PenguinEino/opensusi-tr10-balanced-ternary-logic/layout/art/preview.png

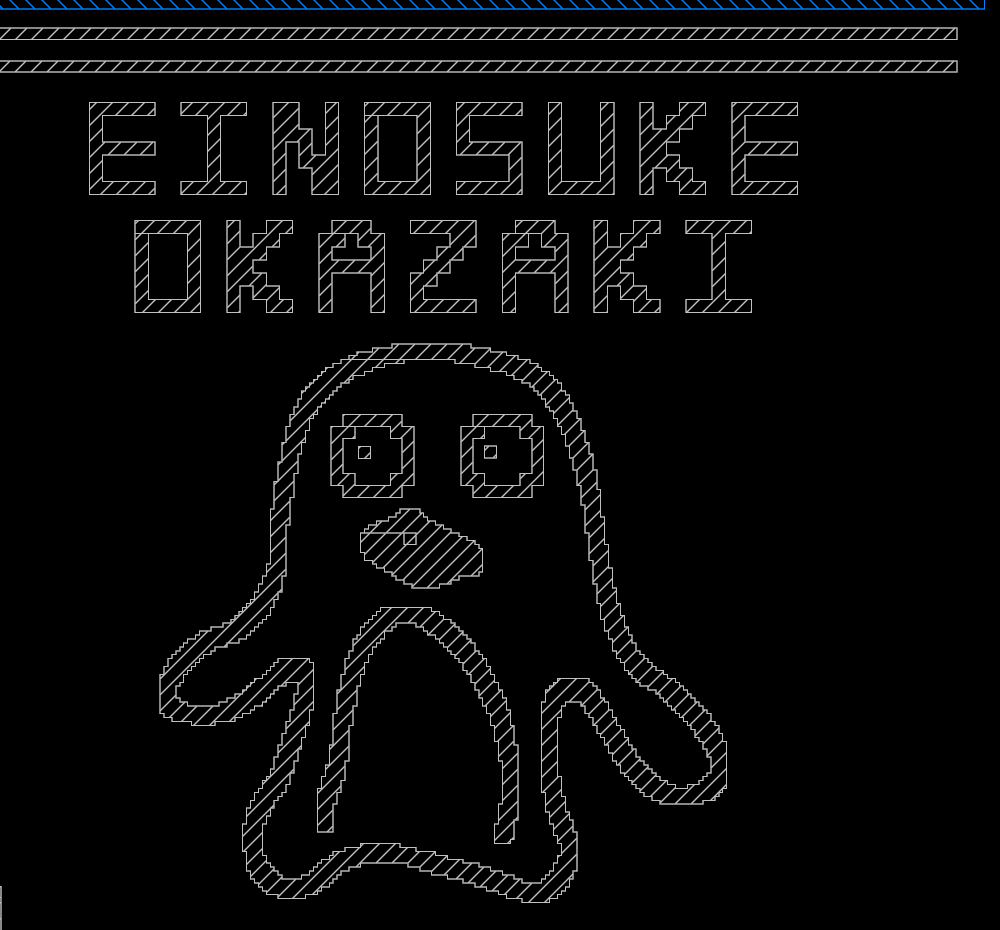
layout/art/preview.png
