PenguinEino/opensusi-tr10-balanced-ternary-logic/layout/full_adder.png

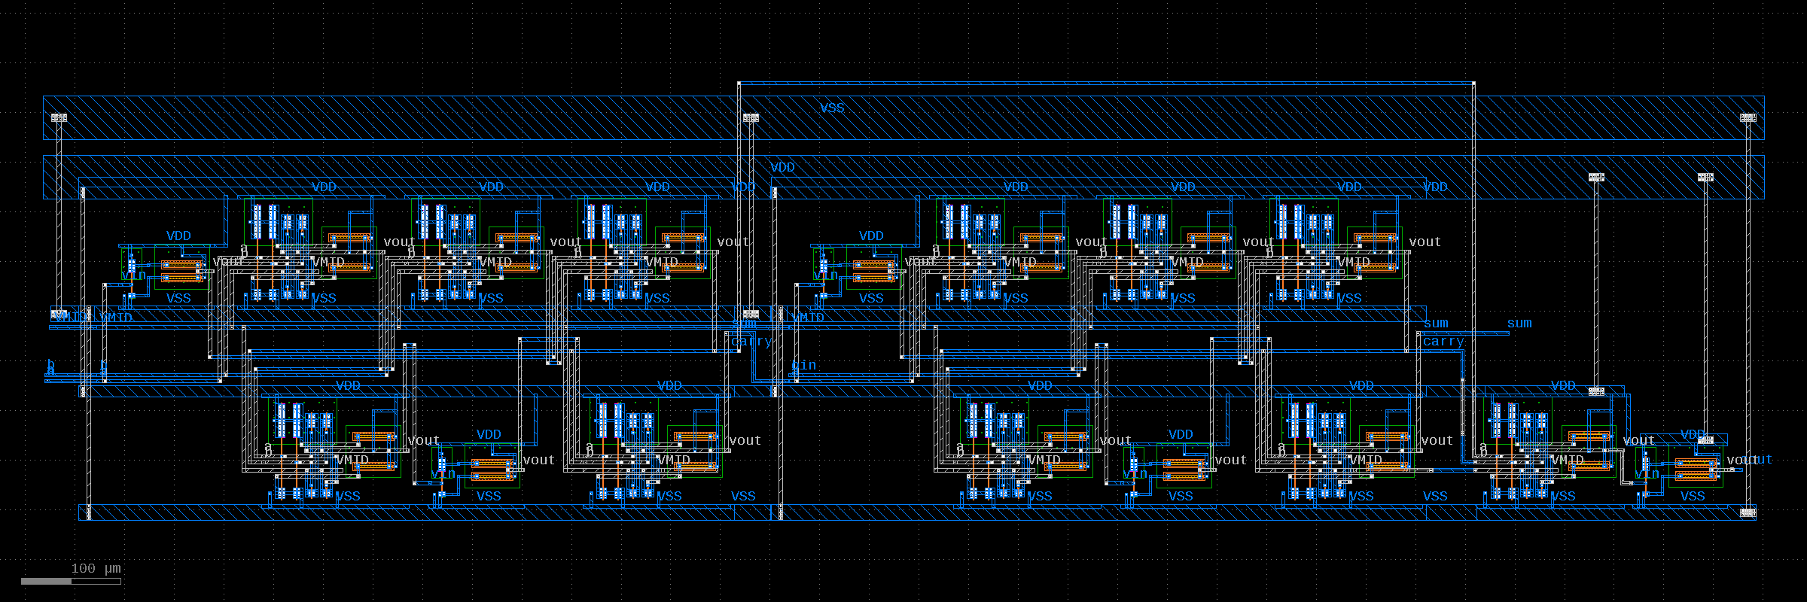
layout/full_adder.png
