PenguinEino/opensusi-tr10-balanced-ternary-logic/layout/half_adder.png

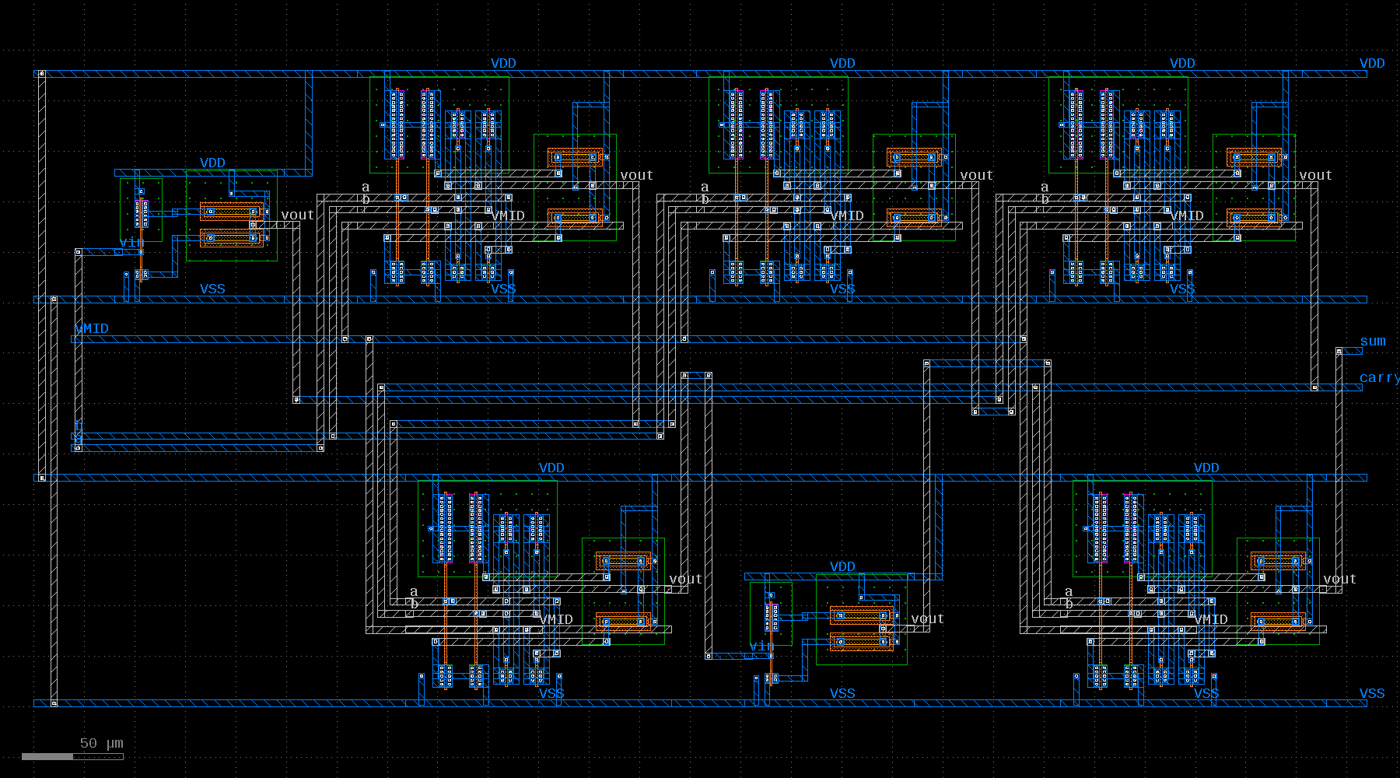
layout/half_adder.png
