PenguinEino/opensusi-tr10-balanced-ternary-logic/layout/inverter.png

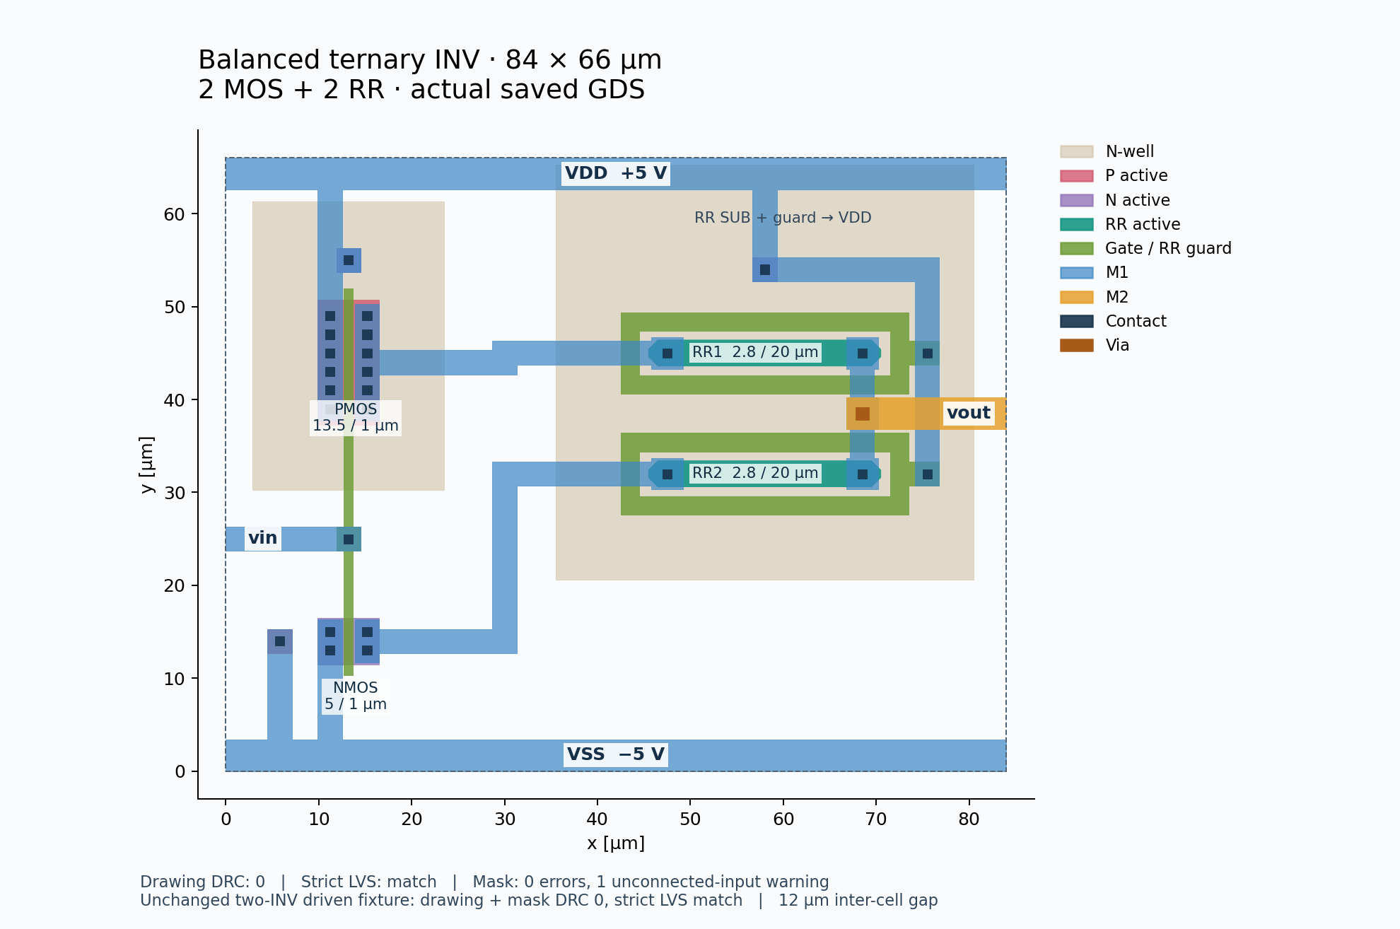
layout/inverter.png
