PenguinEino/opensusi-tr10-balanced-ternary-logic/layout/klayout/readable_terminals.png

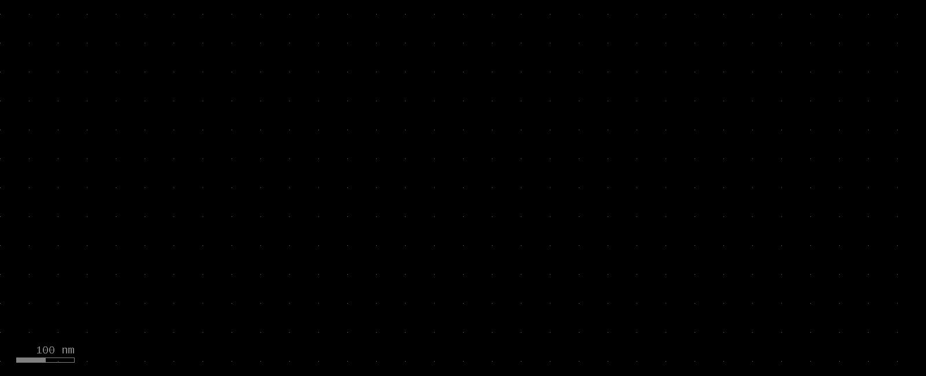
layout/klayout/readable_terminals.png
