PenguinEino/opensusi-tr10-balanced-ternary-logic/layout/mac.png

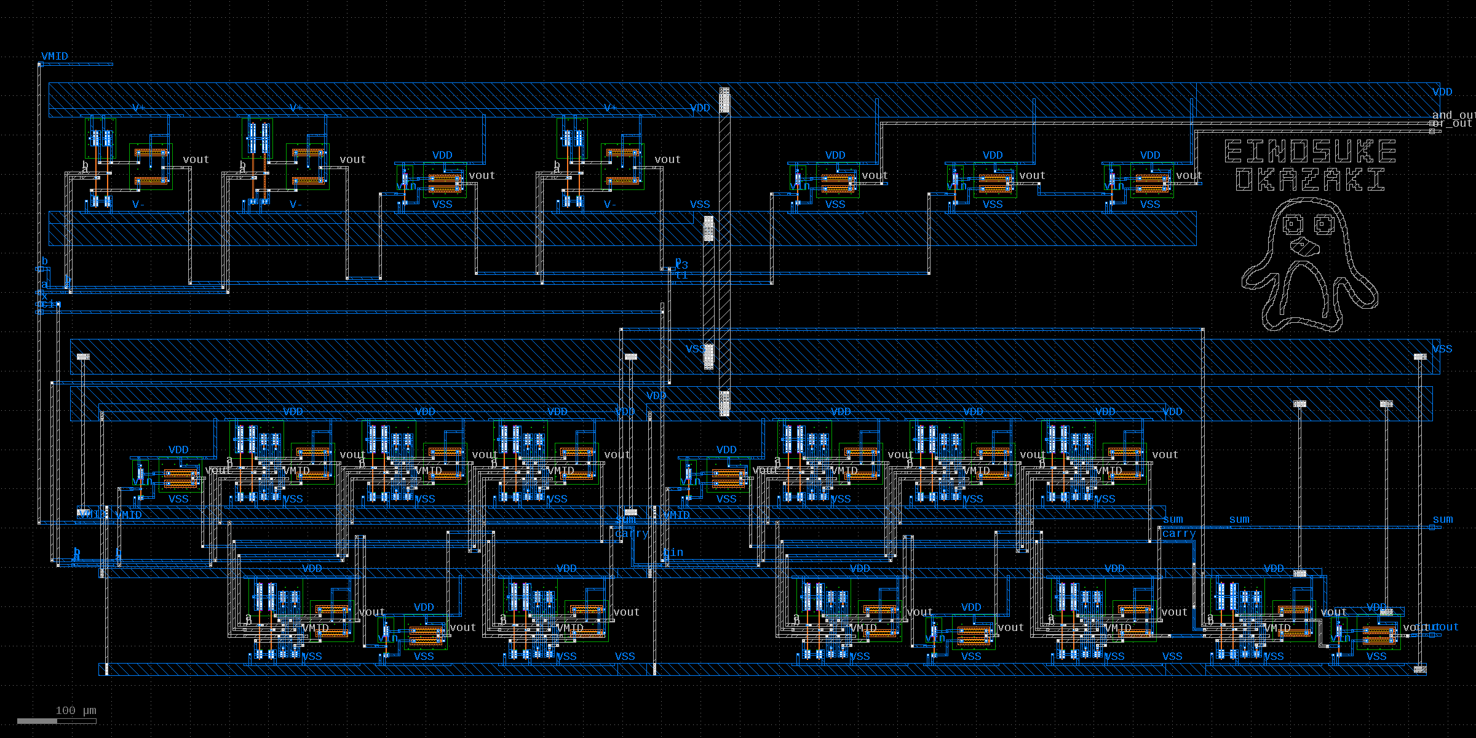
layout/mac.png
