PenguinEino/opensusi-tr10-balanced-ternary-logic/layout/mul.png

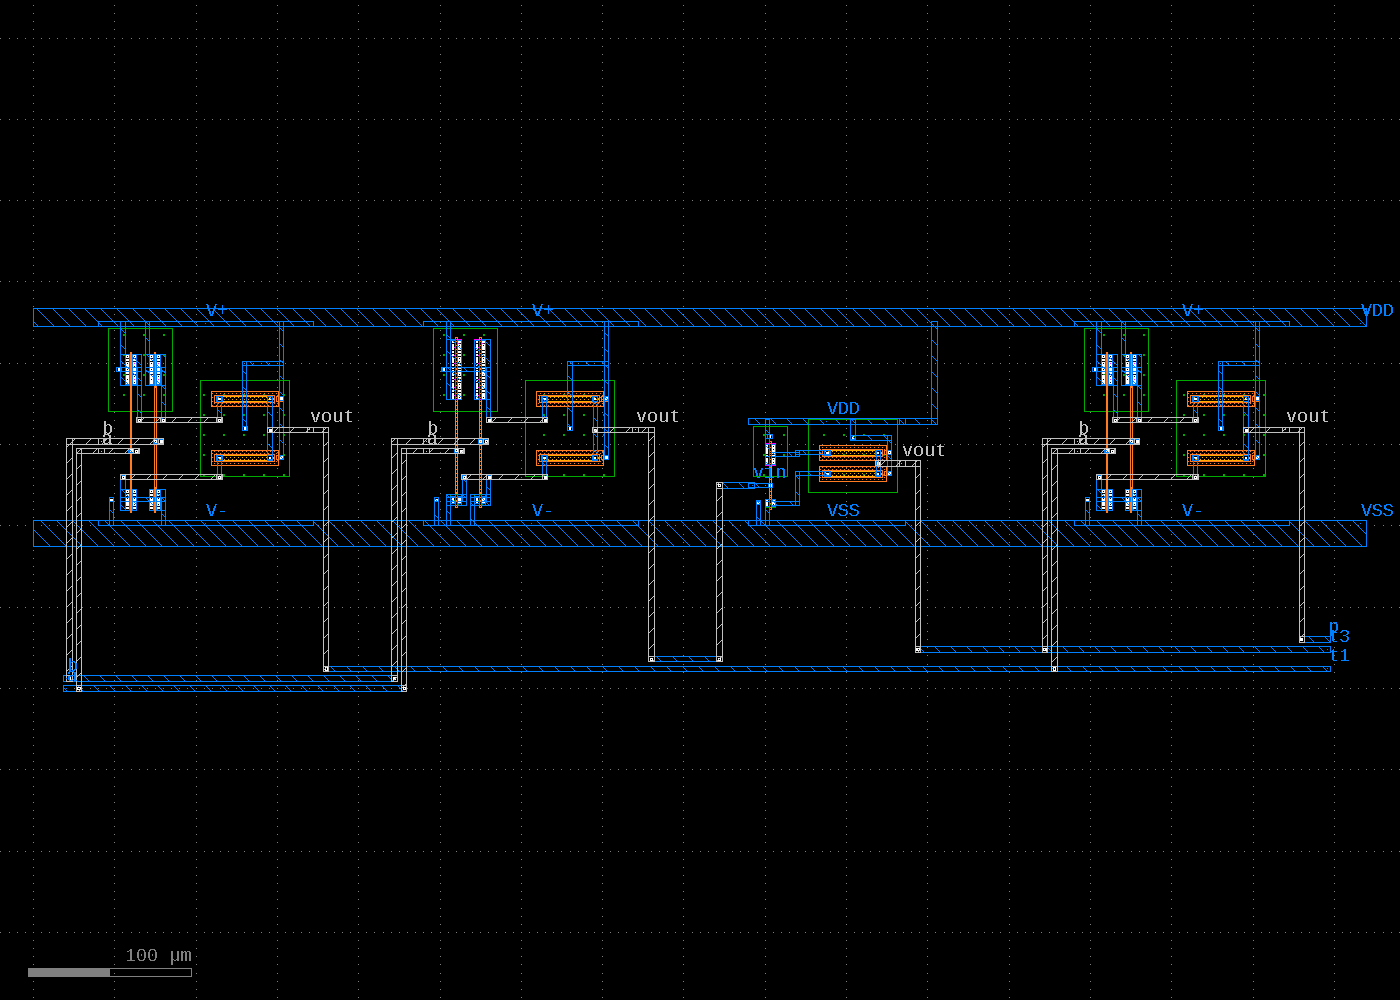
layout/mul.png
