PenguinEino/opensusi-tr10-balanced-ternary-logic/layout/nany.png

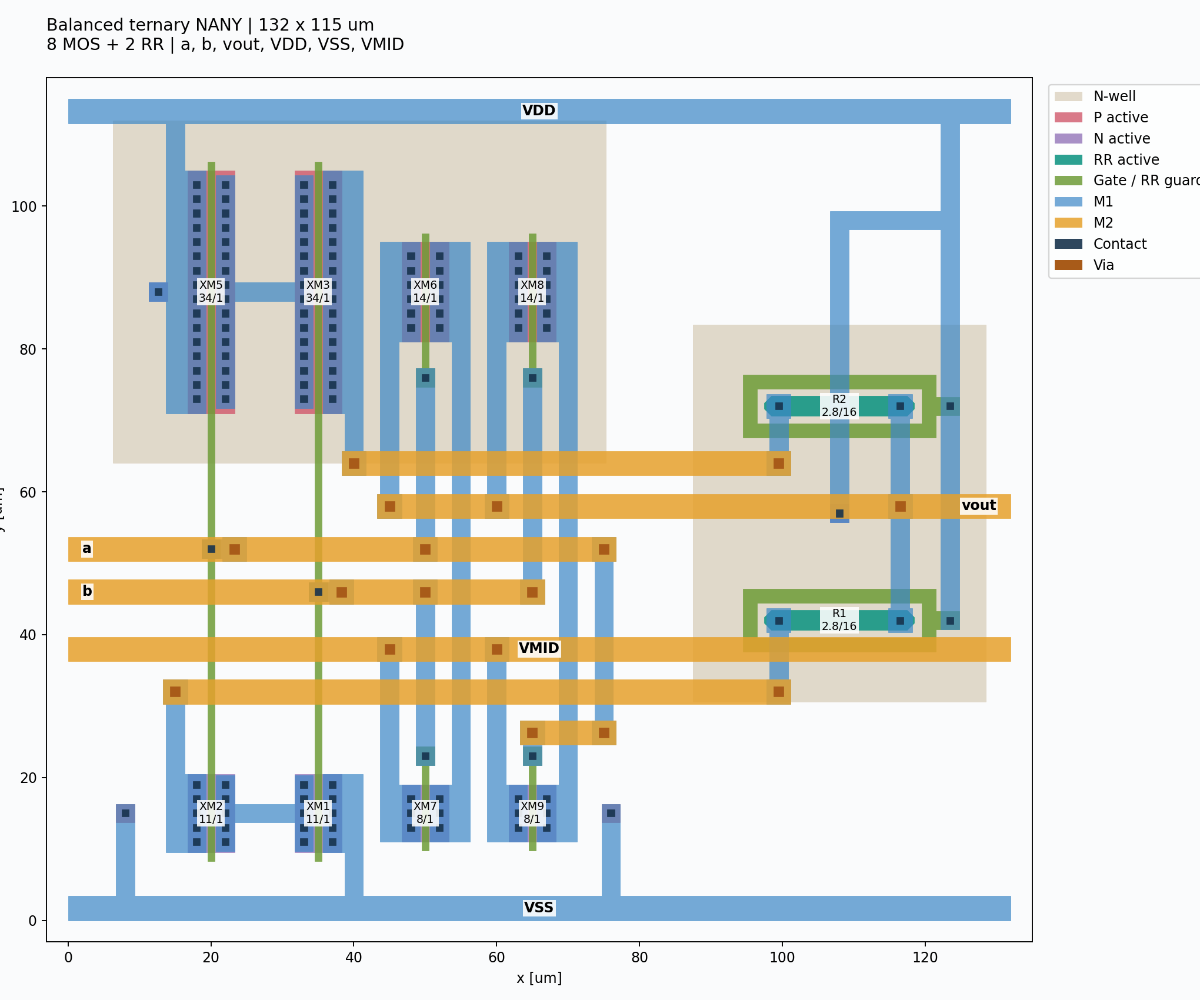
layout/nany.png
