PenguinEino/opensusi-tr10-balanced-ternary-logic/reports/final_review/chain5_carry.png

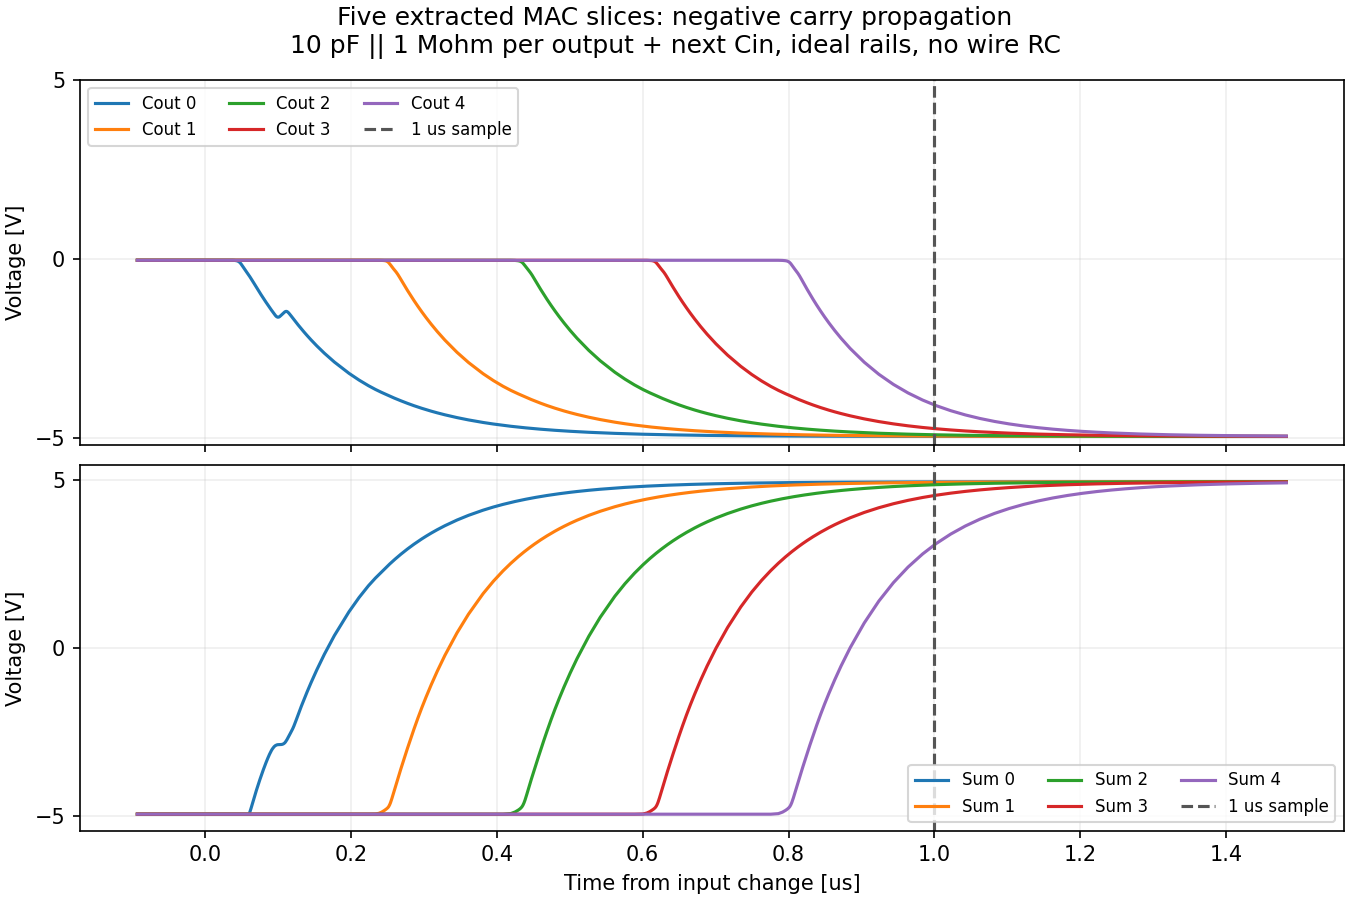
reports/final_review/chain5_carry.png
