PenguinEino/opensusi-tr10-balanced-ternary-logic/submission/mac_pins.png

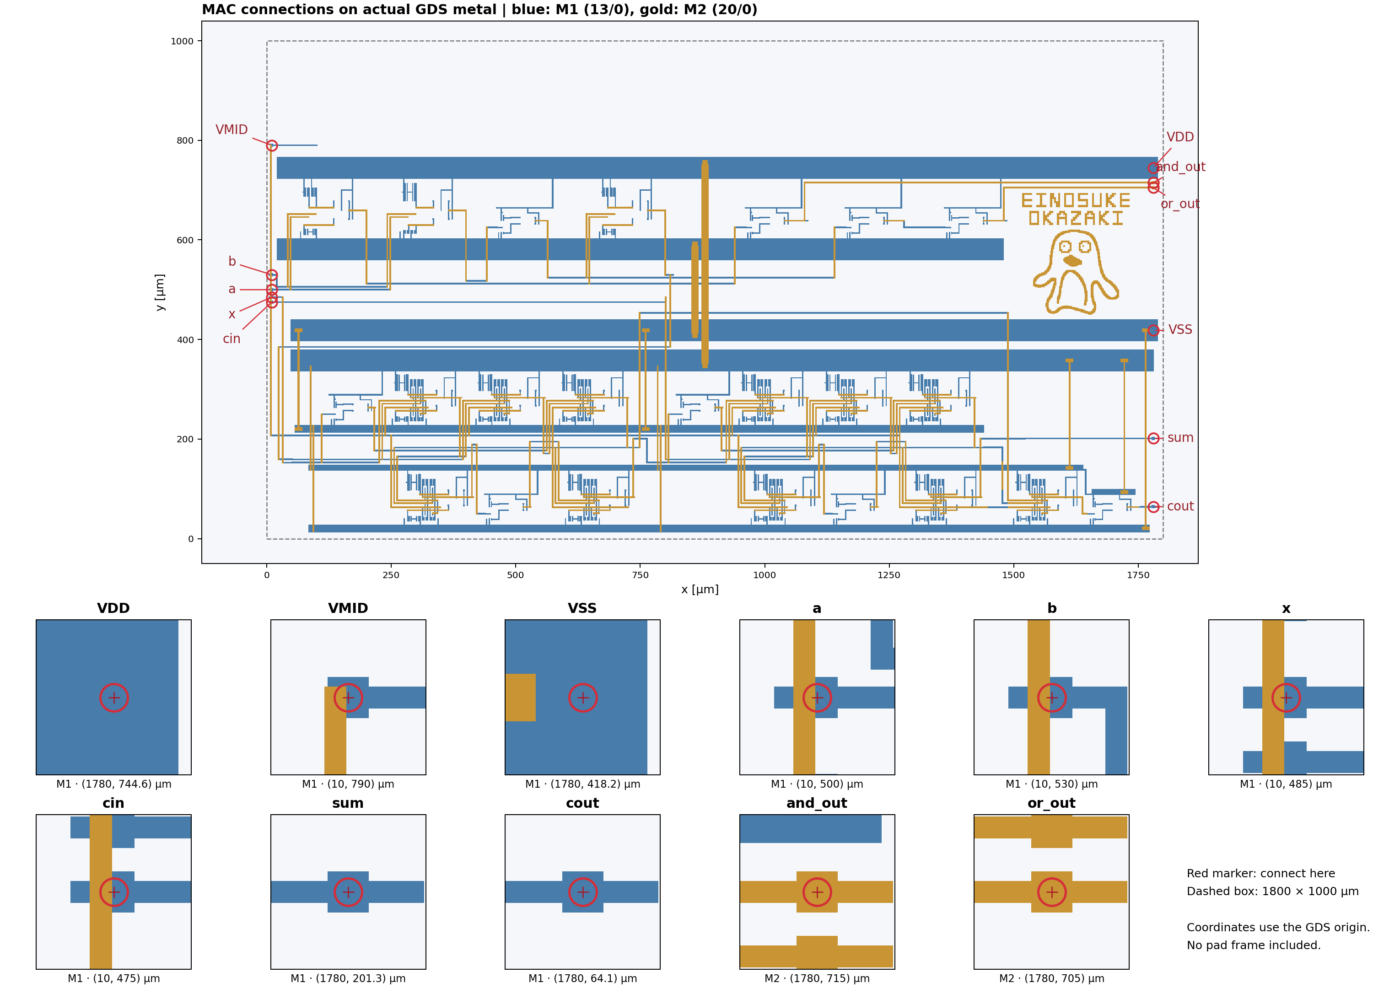
submission/mac_pins.png
