PenguinEino/opensusi-tr10-balanced-ternary-logic/(commit log)

2026-09-23 Record existing ternary circuits and primitive layouts
    [cons.sch, cons_tb.sch, half_adder.sch, half_adder_tb.sch, inverter.sch, inverter_chain_tb.sch, inverter_tb.sch, nand.sch]
2026-09-23 Add hierarchical ternary full adder and validated Xschem testbench
    [full_adder.sch, full_adder_tb.sch]
2026-09-23 Add ternary SRAM latch and access-cell testbenches with read-load characterization
    [ternary_latch.sch, ternary_latch_tb.sch, ternary_sram.sch, ternary_sram_read_tb.sch, ternary_sram_tb.sch]
2026-09-23 Add and size four-gate ternary multiplier with exhaustive transition validation
    [mul.sch, mul_inv.sch, mul_nand.sch, mul_nor.sch, mul_tb.sch]
2026-09-23 Normalize generated MUL schematic trailing whitespace
    [mul_nor.sch]
2026-09-23 Implement hierarchical multiply-add slice and qualify its MUL and MAC layouts
    [mac.sch, mac_tb.sch]
2026-09-23 Record exhaustive schematic and extracted multiply-add verification
2026-09-24 Expose MUL min/max through AND and OR pins with one added inverter
    [mac.sch, mac_tb.sch, mul.sch, mul_tb.sch]
2026-09-24 Package portable MAC submission with schematics, specifications and pin figures
    [full_adder.sch, half_adder.sch, inverter.sch, mac.sch, mac_tb.sch, mul.sch, mul_inv.sch, mul_nand.sch]
2026-09-24 Review MAC electrical ratings, power routing and operating margins
2026-09-24 Improve MAC output loading and power distribution; qualify dev layout
    [inverter.sch, mac.sch, mac_tb.sch, mul_inv.sch, mul_nand.sch, mul_nor.sch, nany.sch]
2026-09-24 Characterize MAC supply limits and preserve reproducible verification inputs
    [inverter.sch, mac.sch, mac_tb.sch, mul_inv.sch, mul_nand.sch, mul_nor.sch, nany.sch]
2026-09-24 Lower MAC supply rails to align with MUL VDD
2026-09-24 Align MAC upper cells and supply rails; requalify layout and submission
2026-09-24 Stitch matching lower FA power rails and refresh qualified submission
2026-09-24 Document primitive circuits and clarify arithmetic truth tables
